nimishwadekar/Smart-Garage-System/README.md

# Smart-Garage-System
Design and Simulation of an embedded Smart Garage System

This repository contains the on-paper design and a simulation (using software Proteus) of a Smart Garage System. 
It is an application of the knowledge gained over the entirety of the course "Microprocessors, Programming and Interfacing".

It is a system designed around an Intel 8086 processor and various other supplementary chips.
The code of the system has been written in asssembler EMU8086 format and assembled into .bin files using the same.

Datasheets of the various devices and components used in the system are located in the "Manuals" directory.
