nimishwadekar/Smart-Garage-System/Design.pdf

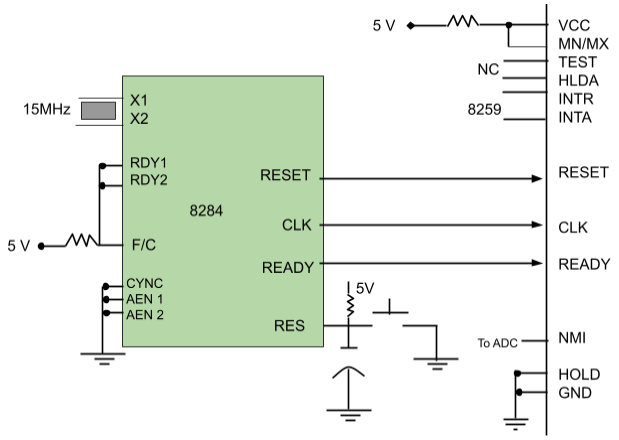
[picture p1: figure]

8086 Inputs and 8284

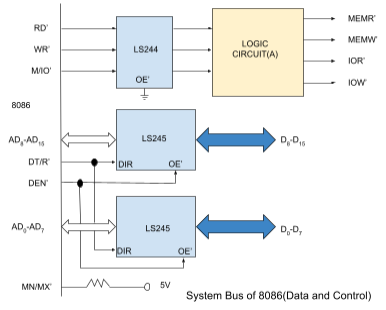
[picture p2: figure]

Data and Control Bus

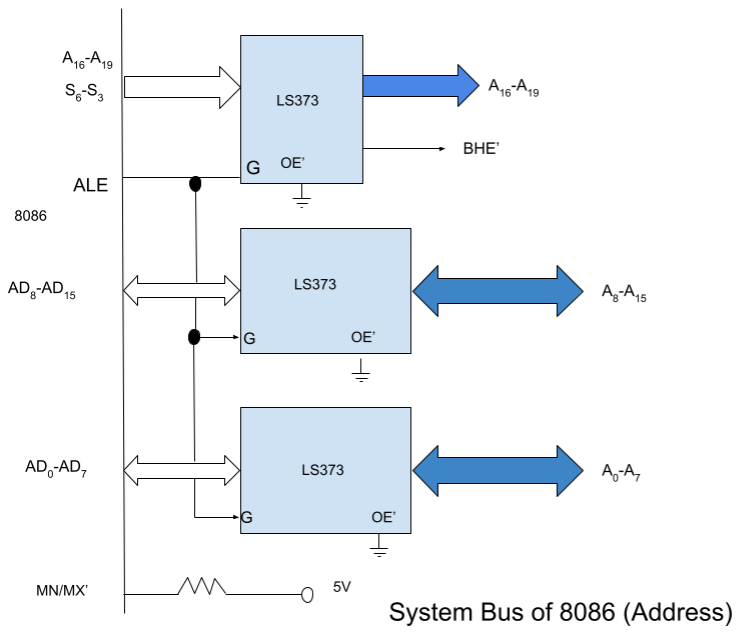
[picture p3: figure]

Address bus

MEMR' | IOR'
MEMW' | IOW'

WRL'

RDH' | WRH'

Control Signals

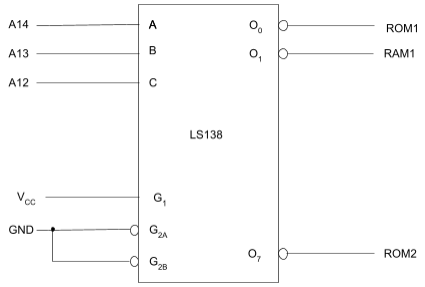
[picture p4: figure]

Memory decoder

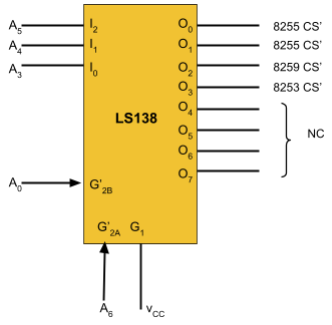
[picture p5: figure]

IO decoder

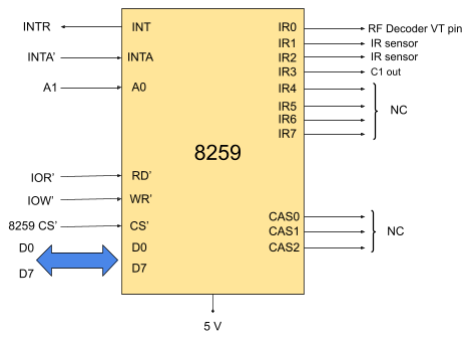
[picture p6: figure]

8259

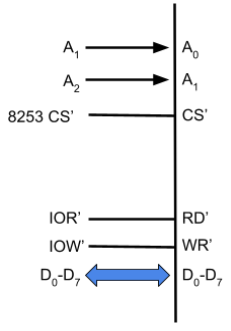
[picture p7: figure]

8253 Interface to the processor

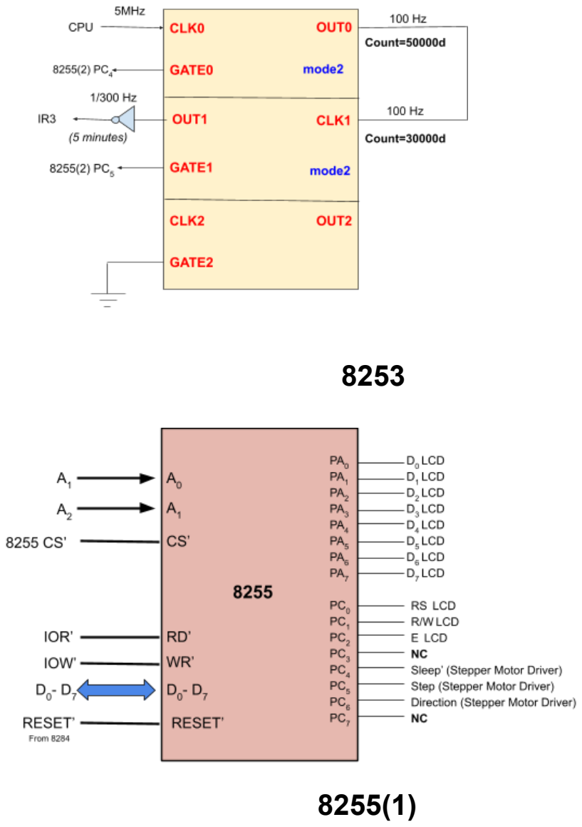
[picture p8: page 6]

8253

8255(1)

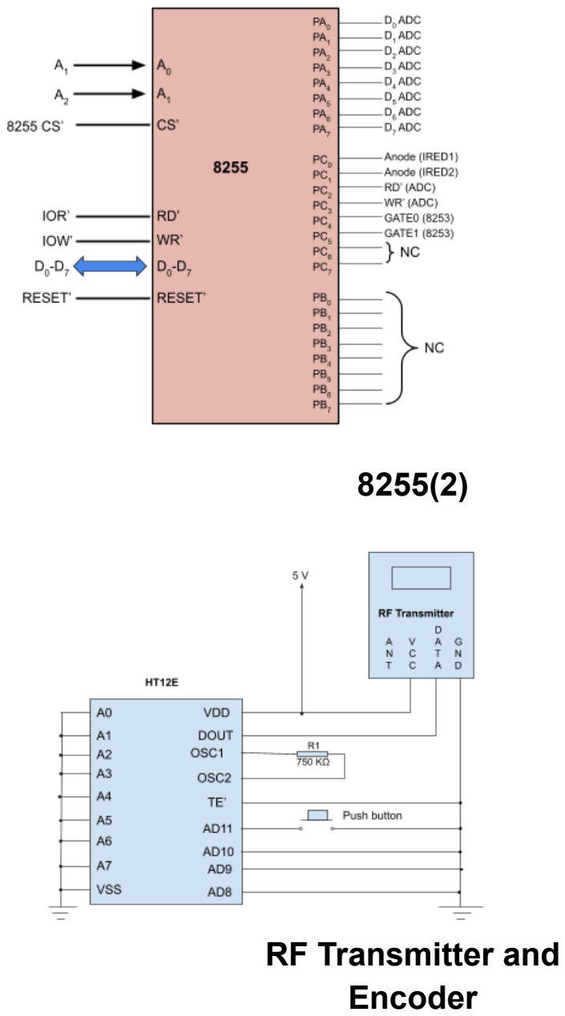
[picture p9: page 7]

8255(2)

RF Transmitter and
Encoder

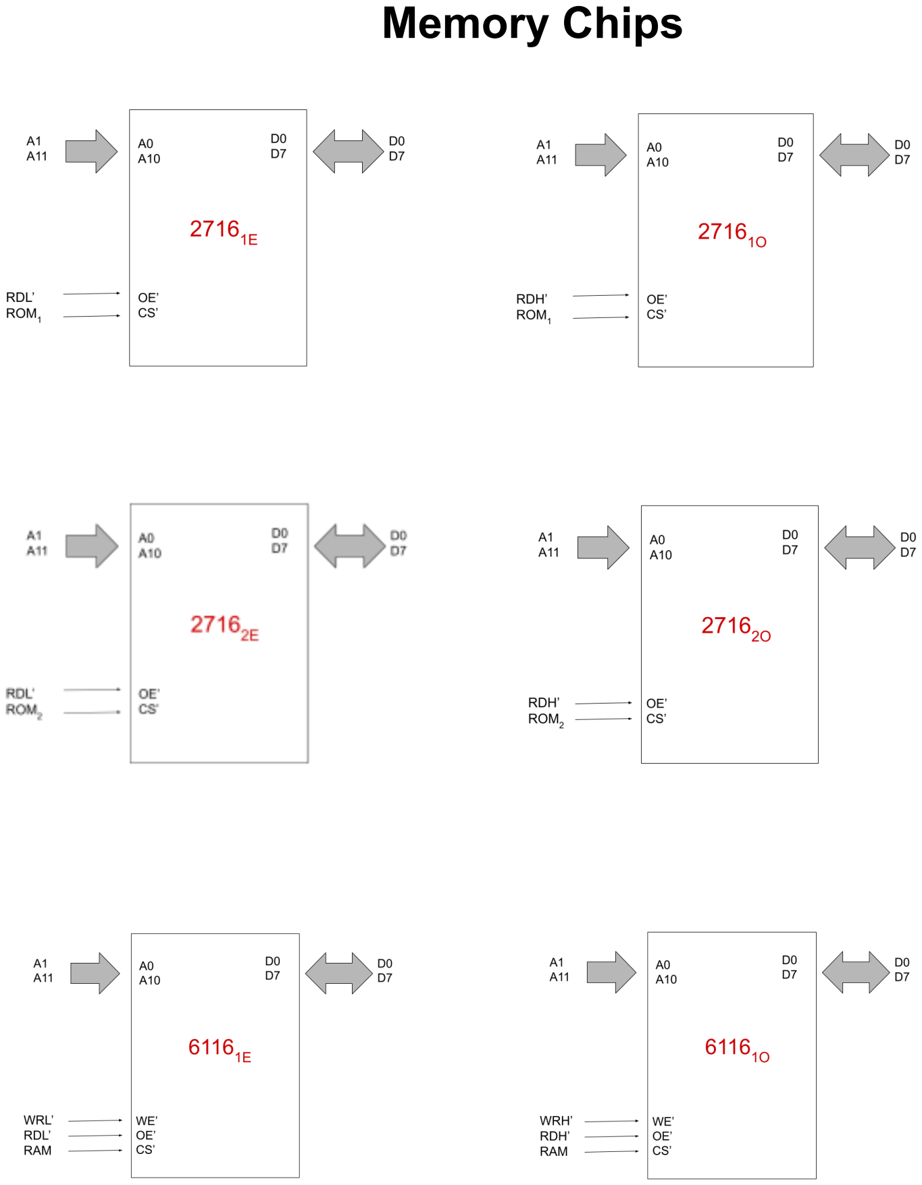
[picture p10: page 8]

Memory Chips

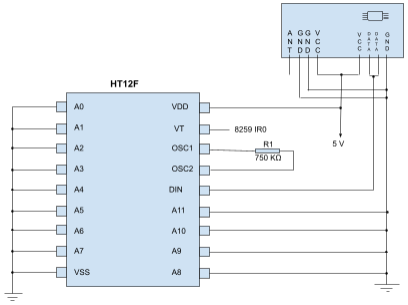
[picture p11: figure]

RF Receiver and Decoder

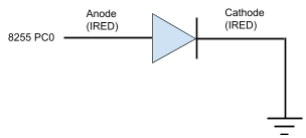
[picture p12: figure]

IRED(1)

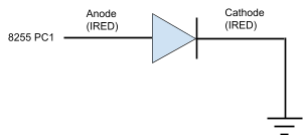
[picture p13: figure]

IRED(2)

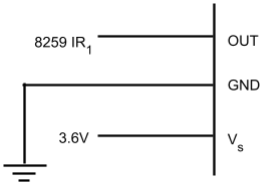
[picture p14: figure]

IR Sensor 1

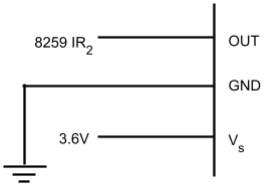
[picture p15: figure]

IR Sensor 2

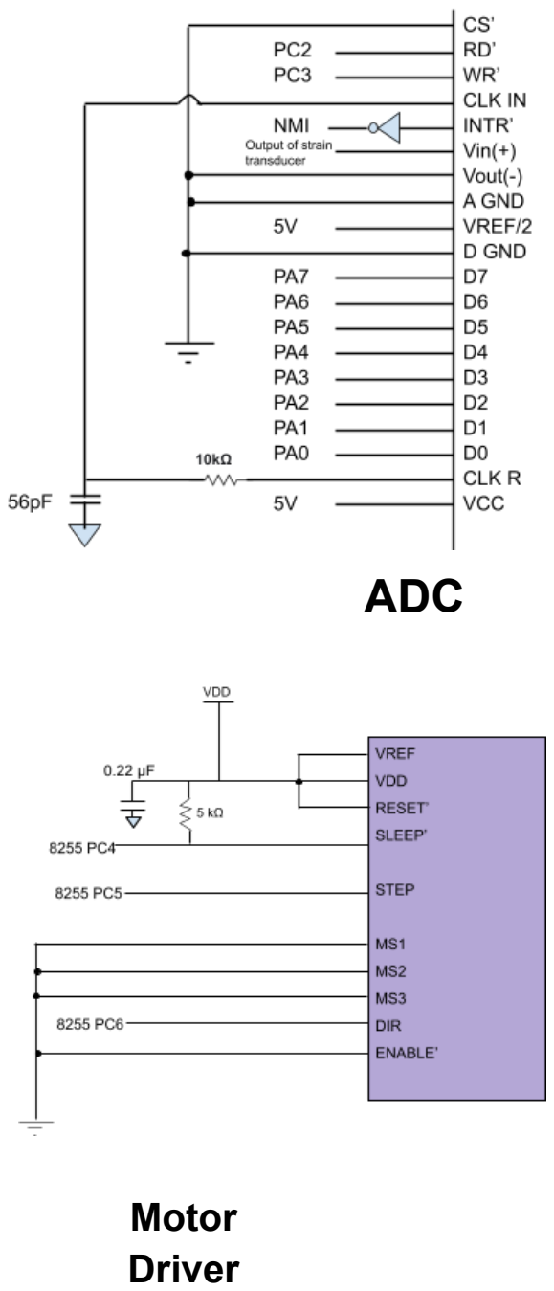
[picture p16: page 11]

### ADC

Motor
Driver

### LCD

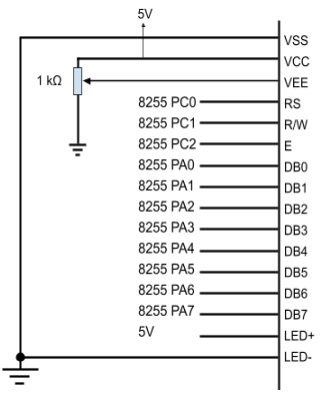
[picture p17: figure]
