nimishwadekar/Smart-Garage-System/(list of files, drawings)

Other design files:
Simulation.DSN
